RadoslawLukasik/PicoWheel/PicoWheelBaseAndSteering.3mf

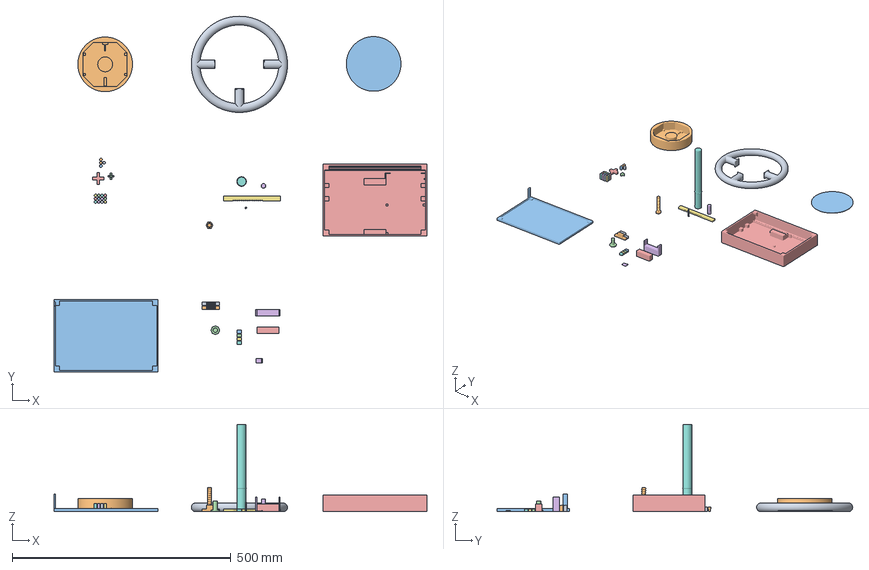
[picture p1: CAD file, 2026-10-28]
PicoWheelBaseAndSteering.3mf
853.0 x 813.0 x 200.0 mm
OuterPart
CenterPart
Cover
Button x 12
DPadButton x 4
DPadCross2
DPadCross
Pinion
Rack
Rod
Rear blockade
Wheel bolt (weak)
Rack stopper x 4
Bearing holder front
Bearing holder rear
rubber holder x 2
Base top
Knob
Base bottom
pot blockade
