RadoslawLukasik/PicoWheel/PicoWheelPedals.3mf

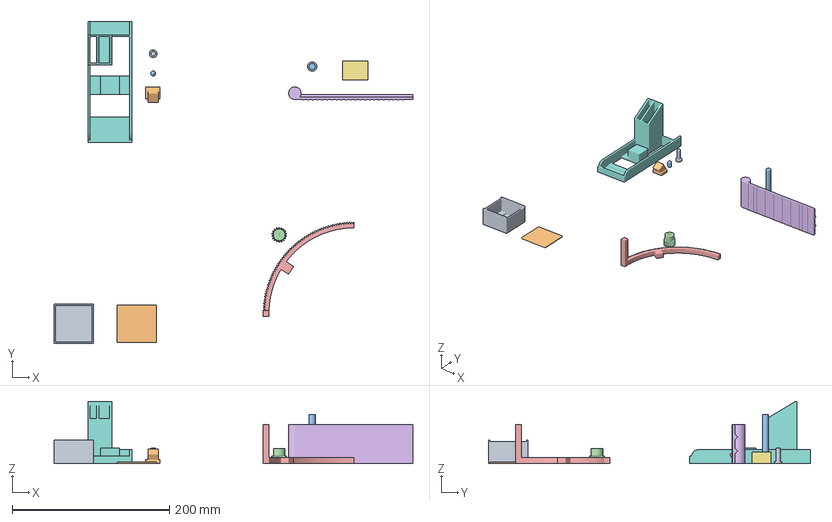
[picture p2: CAD file, 2026-10-28]
PicoWheelPedals.3mf
456.0 x 409.0 x 79.2 mm
pedal pcb
top
rod
Gear18.stl
Montaż
pedal
spring holder
base
upper blockade
down blockade
gear blockade
