RadoslawLukasik/PicoWheel/PicoWheelWiring.pdf

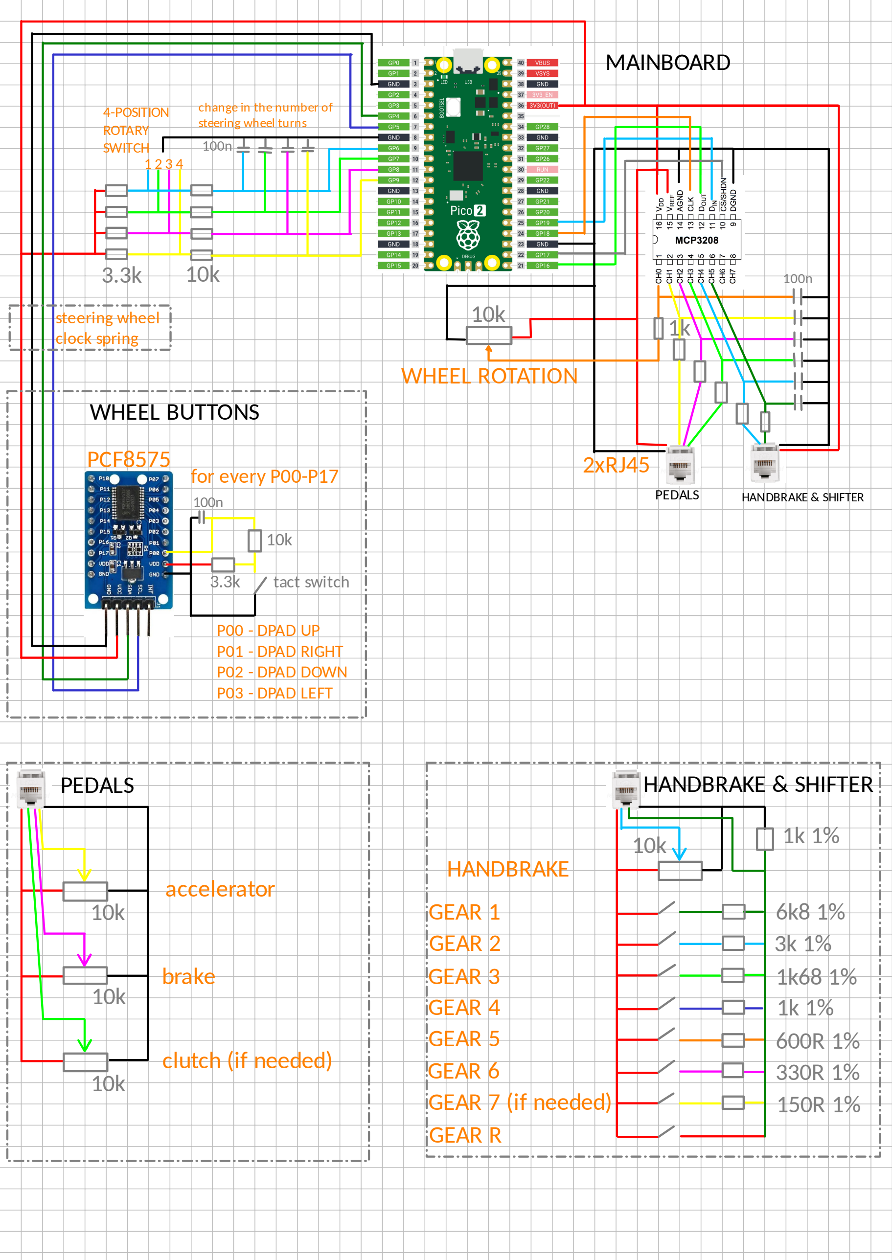
[picture p3: figure]
2xRJ45; WHEEL ROTATION; PEDALS; PCF8575; tact switch; for every P00-P17; HANDBRAKE & SHIFTER; steering wheel clock spring; accelerator; brake; clutch (if needed); HANDBRAKE; GEAR 3 GEAR 4 GEAR 5 GEAR 6 GEAR 7 (if needed) GEAR R; GEAR 1 GEAR 2; P00 - DPAD UP P01 - DPAD RIGHT P02 - DPAD DOWN P03 - DPAD LEFT; MAINBOARD; WHEEL BUTTONS; change in the number of steering wheel turns; 4-POSITION ROTARY SWITCH
